tykus160/light_follower/project/schem2.brd

## EAGLE design project/schem2.brd (2018-04-10)

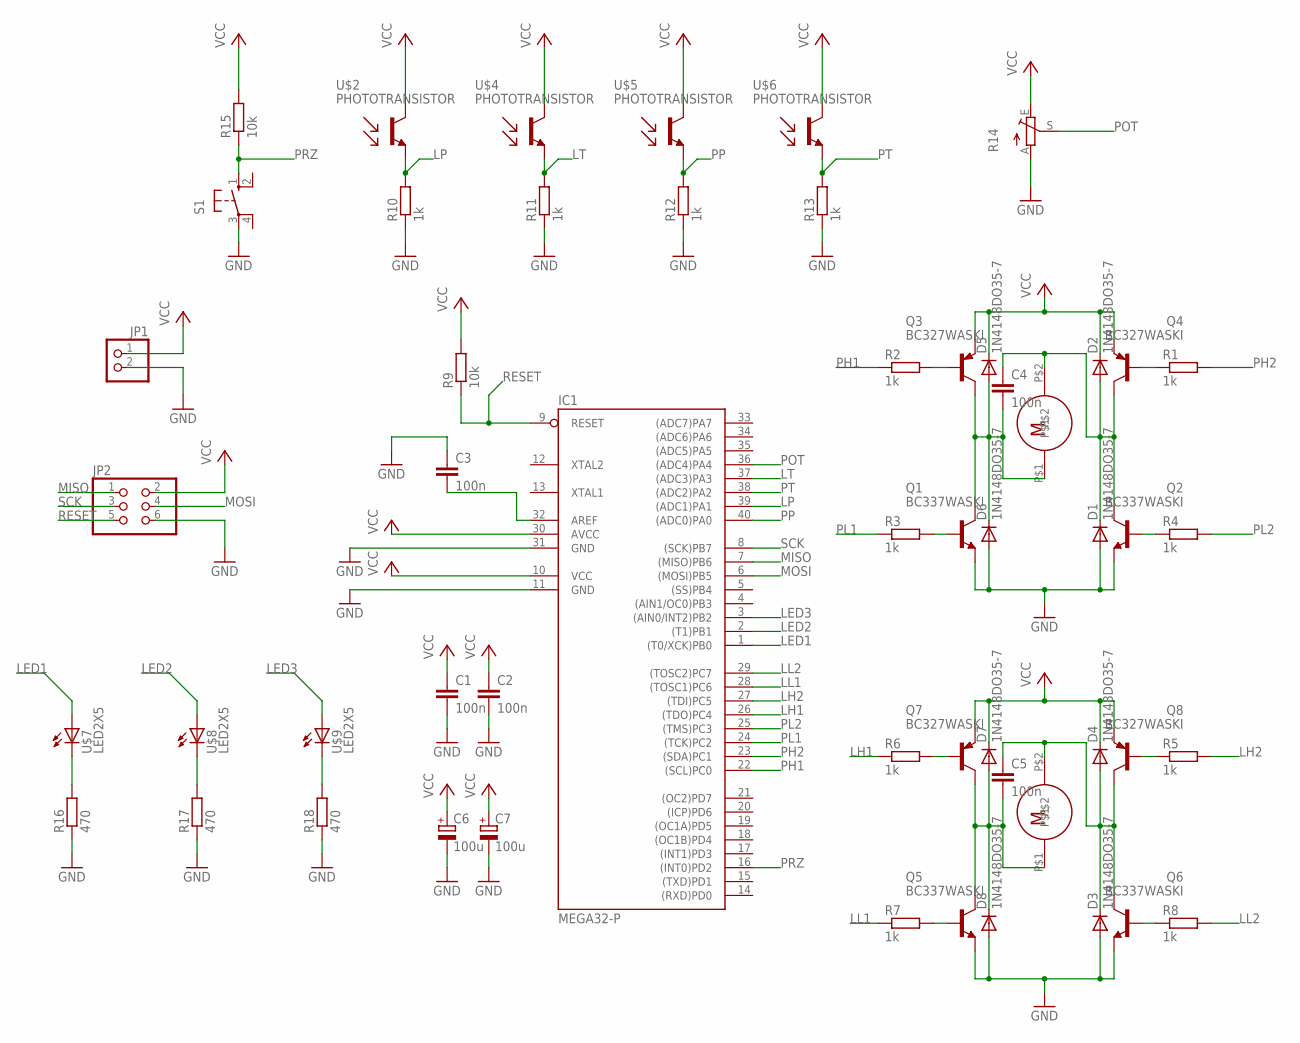
[picture p6: schematic schem2.sch]

Parts:
C1, C2, C3, C4, C5: 100n; C025-025X050
C6, C7: 100u; E2-5
D1, D2, D3, D4, D5, D6, D7, D8: 1N4148DO35-7; DO35-7
IC1: MEGA32-P; DIL40
JP1: PINHD-1X2; 1X02
JP2: PINHD-2X3; 2X03
Q1, Q2, Q5, Q6: BC337WASKI; TO92-WASKI
Q3, Q4, Q7, Q8: BC327WASKI; TO92-WASKI
R1, R2, R3, R4, R5, R6, R7, R8, R10, R11, R12, R13: 1k; 0207/7
R9, R15: 10k; 0207/7
R14: TRIM_EU-B64Y; B64Y
R16, R17, R18: 470; 0207/7
S1: 10-XX; B3F-10XX
U$1, U$3: DG02S
U$2, U$4, U$5, U$6: PHOTOTRANSISTOR
U$7, U$8, U$9: LED2X5; LED3MM

Connections:
GND: C1.2, C2.2, C3.1, C6.-, C7.-, D1.A, D3.A, D6.A, D8.A, IC1.11 (GND), IC1.31 (GND), JP1.2, JP2.6, Q1.E, Q2.E, Q5.E, Q6.E, R10.1, R11.1, R12.1, R13.1, R14.A, R16.1, R17.1, R18.1, S1.3
LED1: IC1.1 ((T0/XCK)PB0), U$7.A
LED2: IC1.2 ((T1)PB1), U$8.A
LED3: IC1.3 ((AIN0/INT2)PB2), U$9.A
LH1: IC1.26 ((TDO)PC4), R6.1
LH2: IC1.27 ((TDI)PC5), R5.2
LL1: IC1.28 ((TOSC1)PC6), R7.1
LL2: IC1.29 ((TOSC2)PC7), R8.2
LP: IC1.39 ((ADC1)PA1), R10.2, U$2.E
LT: IC1.37 ((ADC3)PA3), R11.2, U$4.E
MISO: IC1.7 ((MISO)PB6), JP2.1
MOSI: IC1.6 ((MOSI)PB5), JP2.4
unnamed: C4.2, D5.A, D6.C, Q1.C, Q3.C, U$1.P$1
unnamed: C4.1, D1.C, D2.A, Q2.C, Q4.C, U$1.P$2
unnamed: C5.2, D7.A, D8.C, Q5.C, Q7.C, U$3.P$1
unnamed: R16.2, U$7.K (C)
unnamed: Q7.B, R6.2
unnamed: Q8.B, R5.1
unnamed: Q3.B, R2.2
unnamed: Q4.B, R1.1
unnamed: Q2.B, R4.1
unnamed: Q1.B, R3.2
unnamed: Q6.B, R8.1
unnamed: Q5.B, R7.2
unnamed: C5.1, D3.C, D4.A, Q6.C, Q8.C, U$3.P$2
unnamed: C3.2, IC1.32 (AREF)
unnamed: R17.2, U$8.K (C)
unnamed: R18.2, U$9.K (C)
PH1: IC1.22 ((SCL)PC0), R2.1
PH2: IC1.23 ((SDA)PC1), R1.2
PL1: IC1.24 ((TCK)PC2), R3.1
PL2: IC1.25 ((TMS)PC3), R4.2
POT: IC1.36 ((ADC4)PA4), R14.S
PP: IC1.40 ((ADC0)PA0), R12.2, U$5.E
PRZ: IC1.16 ((INT0)PD2), R15.1, S1.1 (S)
PT: IC1.38 ((ADC2)PA2), R13.2, U$6.E
RESET: IC1.9 (RESET), JP2.5, R9.1
SCK: IC1.8 ((SCK)PB7), JP2.3
VCC: C1.1, C2.1, C6.+, C7.+, D2.C, D4.C, D5.C, D7.C, IC1.10 (VCC), IC1.30 (AVCC), JP1.1, JP2.2, Q3.E, Q4.E, Q7.E, Q8.E, R9.2, R14.E, R15.2, U$2.C, U$4.C, U$5.C, U$6.C

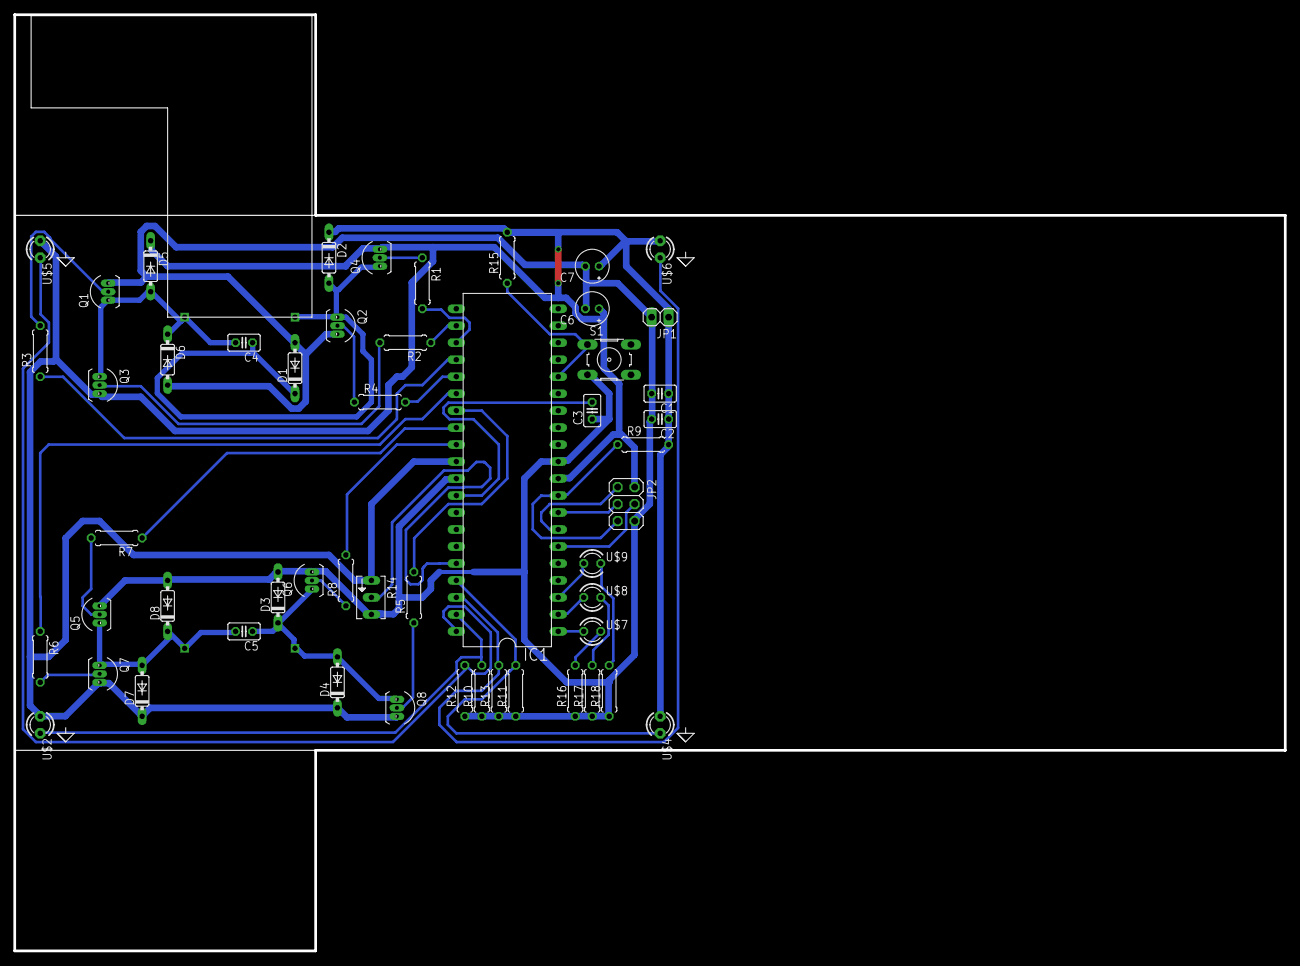
[picture p7: board schem2.brd from above]

Board: 2 copper layers, 190.0 x 140.0 mm, 54 parts (1 on the bottom side), 39 nets.
